Mihanikuz/home_asist_fan/files/Schematic_t-fun_2025-05-18.pdf

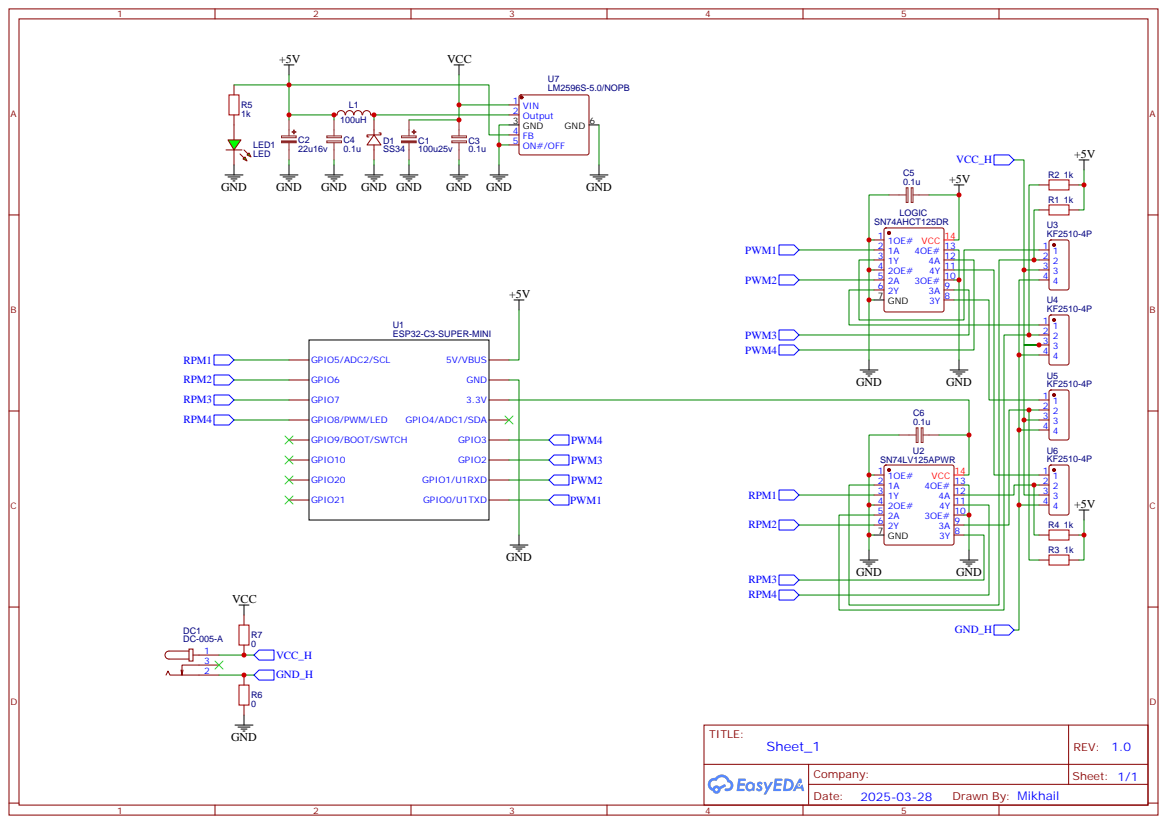
[picture p4: page 1]
