Mihanikuz/home_asist_fan/files/PCB_PCB_t-fun_4_2025-05-18.pdf

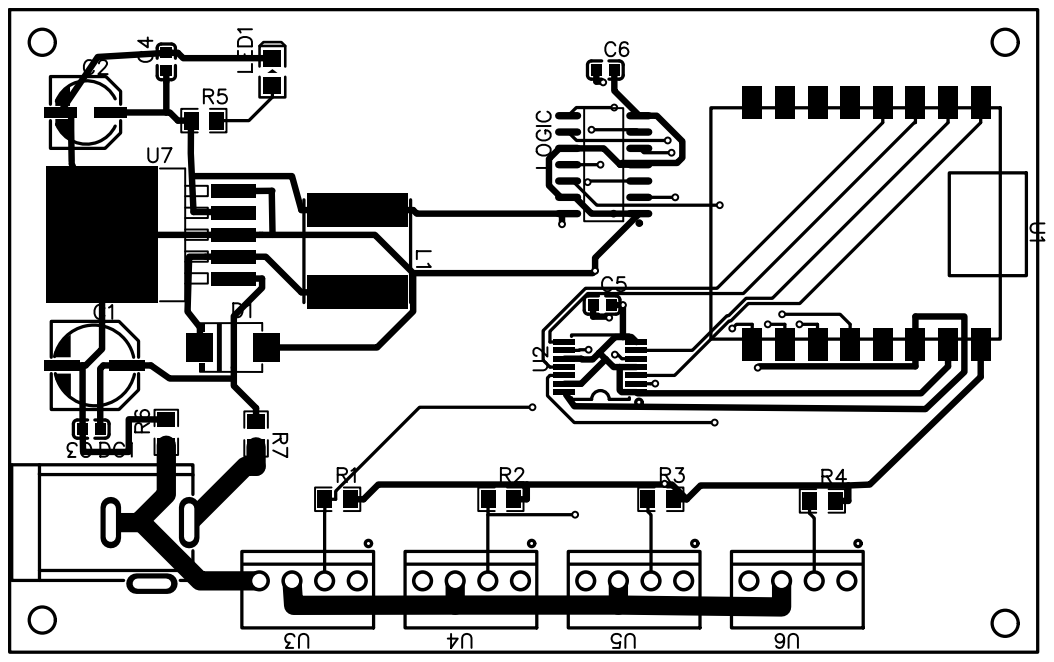
[picture p5: page 1]
